NestOfGhosts/3d-chase/README.md

# 3d-chase
3d cube of led's as interface for simple game of snake without the body of the snake. Made by me for Hack Club Half Life.

Dear hack club reviewer. You may notice that most of the images are absolute garbage. Most are placeholders for when i do the project personally, and when I do ill add better images and remove this comment

## Premise

3d led cube:



But it's snake:



But the cube is 9x9x9 so i dont think the snake's body would work, so it's just going to be a led moving towards blinking leds.

### The game explaination
These are what the keys map to.



PWR just start the game, and does nothing beyond that. Why is it called PWR? Because I thought i was going to do more with the button. The other keys that move you along the x,y, and z axis.

You start in (0,0,0(Corner of the cube)) as the lit up led, and the goal starts in (1,1,1 (center of the cube)) as the blinking led. 
You have 3.5 seconds to move your light to the goal. A new goal will spawn, and every 3 points the time limit will go down. 

Here are the values for every time decrease (in milliseconds): 3500, 2940, 2505, 2168, 1907, 1703, 1546, 1424, 1329, 1255, 1198, 1154, 1119, 1093, 1072, 1056, 1043, 1034, 1026, 1020, 1016, 1012, 1009, 1007, 1006, 1005, 1004, 1003, 1002, 1001, 1000.

Past 90 points, the time stays at a static 1000 milliseconds (1 second). You effectively win if you can get to the points within 1 second without making a mistake. If you get to that level, you can try editing the firmware to have a different/steeper decrease slope.

If you move into a wall you fail.

### Additional Note
If you keep it plugged in it will go into a standby mode, where it'll randomly turn on the cubes leds until the cube is filled, then it'll clear it. Lets the cube work as simple decoration.

## Stuff you need

[BOM.csv](https://github.com/NestOfGhosts/3d-chase/blob/main/BOM.csv) is just a copy of the things I personally had to buy for the project and their prices, not a complete list of things you need. The following table is the complete parts list.

|Thing you need|What you need it for|
|---|---|
|Soldering equipment and expertise|A simple soldering iron and through-hole skills needed|
|[The Pcb](https://github.com/NestOfGhosts/3d-chase/tree/main/Pcb%20Files)|To hold everything together|
|[The Chassis](https://github.com/NestOfGhosts/3d-chase/tree/main/Chassis%20Files)|To hold everything together but in like a different way :3|
|Arduino Nano Atmega328 with usb c|Just kinda get some clone or something that seems legit enough and compatible/same pin layout as og nano. I got mine from [Aliexpress](https://www.aliexpress.com/item/1005006128051481.html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)|
|7 switches and keycaps|For the controls. Make sure they're mx compatible and 5 pin. MAKE SURE THEY'RE 5 PIN|
|27 Diode leds|The ones with only an anode and cathode, in any colour of your choosing. Im using flattop whites|
|3 Mosfets|Allows you to open and close electrical paths|
|9 ~130-330 ohm resistors|To limit electric flow going to leds. Higher number is more resistant = duller leds. Recommended ohm value is for white leds|
|3 4.7k-100k ohm resistors|Closes electrical path if mosfet isnt *fully* off|
|M4 screws and nuts|To hold the chassis together|
|Wires|I'm using some spare jumpers. Make sure you can connect points at ~20mm, ~40mm, ~60mm. (120mm of wires)|

### Additional notes: 
  - I got my pcb and chassis from JLCPCB and JLC3DP (respectively).
  - The pcb is fully designed for through hole parts
  - Flat topped, diffused leds work better for this projects, because realistically you're looking at the leds from multiple angles and you will be looking at them for periods of time (diffused spreads light out and reduces sharpness). However, diffused leds are expensive, so you can sand the led lightly with a high grit sandpaper (400-1000). Higher is less diffused.
  - Colour of leds correspond to resistor strengths. If you want a different led colour google "____ led resistor ohm"
  - The screws are ISO7380 M4. You may need to edit chassis screw holes if the screws you buy are bigger
  - The firmware is built for the old Atmega328 bootloader. If you want to change it you need to copy the firmware folder, open it in [VS Code](https://code.visualstudio.com), and download [Platformio](https://platformio.org/) (you can also find this in vscode's built in extension store). Then, in the platformio.ini folder change from REMEMBER TO CHANGE THIS
  - The resistor value is are for white leds. You can use [All About Circuits Led Resistor Calculators](https://www.allaboutcircuits.com/tools/led-resistor-calculator/) to calculate it. Aim for about roughly 10-20ma~? It really depends on every Led though so the value is a broad number. You can look at the listing for max ma, and maybe do a couple underneath that.

## Assembly
### Firmware
Instructions are windows
1. Download firmware .hex from [the firmware folder](https://github.com/NestOfGhosts/3d-chase/blob/main/FIrmware/firmware.hex) 
2. Download a .hex firmware flasher [Avrdude](https://blog.zakkemble.net/avrdudess-a-gui-for-avrdude/)
3. Open device manager, and expand the "Ports (COM & LPT)"
4. Plug in the nano. A new port should appear. Take note of the COM number (etcetcetc (COM___))
5. In Avrdude, set preset to "Arduino Nano (Atmega328p)". You may have purchased a Nano with a Atmega328 or Atmega328PB MCU. If so, change MCU to the correct one.


6. In Avrdude, set port to the COM number. Other programmer setting should be correct because of the preset.


7. Add the path to the .hex in the "Flash" field. Set it to "Write", and press "Go"
8. Wait until the terminal at the bottom of the gui says "Success" or smth

### Soldering
Hopefully you have a fume extractor, or have accepted asthma and metals in your lungs
1. Solder the Nano, MOSFETS, and resistors on the backside.
2. Solder switches on frontside.
#### The led cube
3. (Optional): Sand your leds if you more diffusion
4. Bend the cathodes(shorter side) of the leds 90 degrees, with a 1-3mm gap between the bottom of the led and the start of the bend
5. Lay out the leds in a 3x3 grid. Match it up with the hole distances in the pcb (all 2 leds are seperated by 15mm). Make a second bend on the horizontal plane to make each distance between leds 15mm.


(PLACEHOLDER IMAGE)

6. Connect the anodes(longer side) up and down. Make the distance between the layers 15mm to make C U B E.


(PLACEHOLDER IMAGE)

7. Get the wires. Make sure both ends are stripped/open/metal. Now solder one end of the wire on one of the three holes to the left of the pcb (pins labeled L1, L2, L3). IMPORTANT: Wire the bottom most layer to L1, top layer to L3 etc


8. Grab the chassis cover, and route the wires through the holes in the cover.
INSERT IMAGE
9. Solder the wires to the 3x3 layers, and solder the anode columns to the pcb
10. Put the chassis together

## Customizing the firmware.
You need to know c++ to do major changes, because platformio uses c++, but I will go through some simple changes if you dont know C++
- Install [Platformio](https://platformio.org/) on [VS Code](https://code.visualstudio.com)
- Download the [3d Chase Folder](https://github.com/NestOfGhosts/3d-chase/tree/main/FIrmware/3d%20Chase%20Firmware) by pasting the url into [Download Github directory](https://download-directory.github.io/)
- Extract the download
- To open the platformio project, follow the first *commenter*'s instructions in [this forum post](https://community.platformio.org/t/guidance-for-a-platform-io-noob/47188) on how to open platformio projects.
- Now, in src, you can find the main.cpp folder. Top of the file has some simple settings like debounce(how long a button has to be held to be considered pressed), how long the goal's blinks are, and how long one frame of the standby's animation is. On line 86, you can also find the time limit curve. If you dont know c++, i recommend maintaining the timeTable at 31 values, but you can adjust the indivisual values, like making the curve go down faster and end at 500, if you want a challenge. If you want a smoother curve than just guessing values you can use a graphing calculator and your favourite function to create your own curve. 

## Arduino Pins, for the nerds:
D0 = Power button
D1, D2, D3, D4, D5, D6 = X+, X-, Y+, Y-, Z+, Z-
D7, D8, D9 = MOS1, MOS2, MOS3
D10, D11, D12, D13, D14, D15, D16, D17, D18 = Column 1, 2, 3, 4, 5, 6, 7, 8, 9
