NestOfGhosts/3d-chase/BOM.csv

Item | Qty | Supplier | Cost/item | Total Cost | link
Mosfet | 3 | Digikey | $1.72 | $5.16 | https://www.digikey.ca/en/products/detail/microchip-technology/TN0702N3-G/4902376
Leds | 100 | Aliexpress | $0.06 | $6.00 | https://www.aliexpress.com/item/1005007478725108.html?mp=1
Resistors (150 ohm) | 12 | Digikey | $0.04 | $0.48 | https://www.digikey.ca/en/products/detail/yageo/MFR-25FBF52-150R/12831
Resistors (7.68 KOhms) | 3 | Digikey | $0.11 | $0.33 | https://www.digikey.ca/en/products/detail/yageo/MFR-25FBF52-7K68/13197
Arduino Nano w/ type C | 1 | Aliexpress | $4.74 | $4.74 | https://www.aliexpress.com/item/1005011773197580.html?mp=1
Screws and nuts (M4) | 5 | Aliexpress | $0.66 | $3.30 | https://www.aliexpress.com/item/1005005971756266.html?mp=1
Pcb | 1 | JLCPCB | $8.80 | $8.80 | https://jlcpcb.com
Chassis | 1 | JLC3DP | $4.32 | $4.32 | https://jlc3dp.com
Estimated total shipping | 1 |  |  | $33.26
