NestOfGhosts/3d-chase/Chassis Files/cassis-Assembly.step

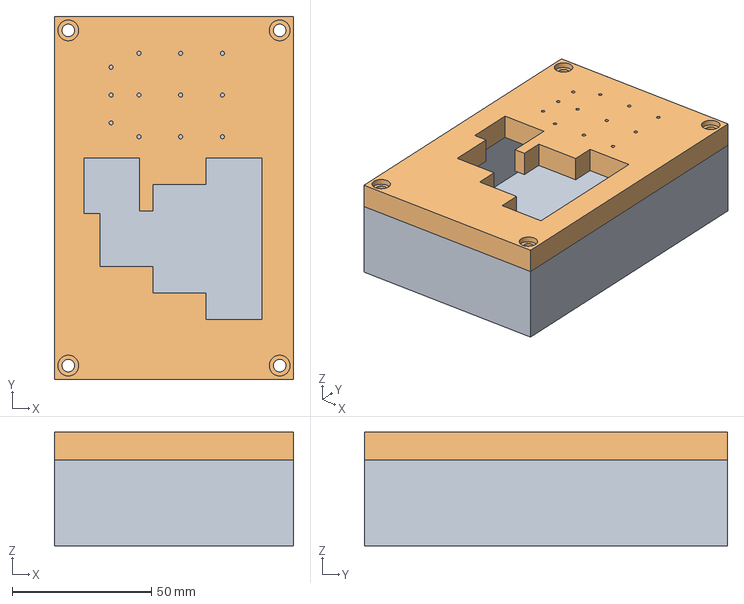
[picture p1: CAD file, 2026-11-01]
Chassis Files/cassis-Assembly.step
86.0 x 130.5 x 40.8 mm
