NestOfGhosts/3d-chase/Chassis Files/Split files/002-Body001(1)-1(1).stl

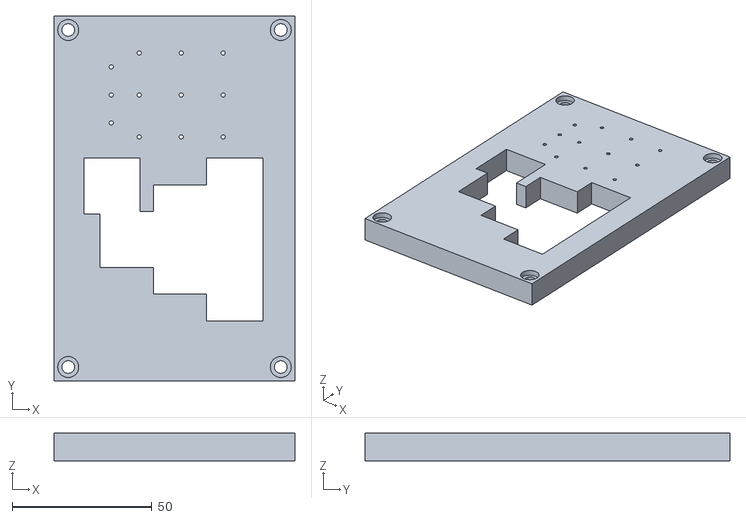
[picture p2: CAD file, 2026-11-01]
Chassis Files/Split files/002-Body001(1)-1(1).stl
86.0 x 130.5 x 10.00
