NestOfGhosts/3d-chase/Chassis Files/cassis.step

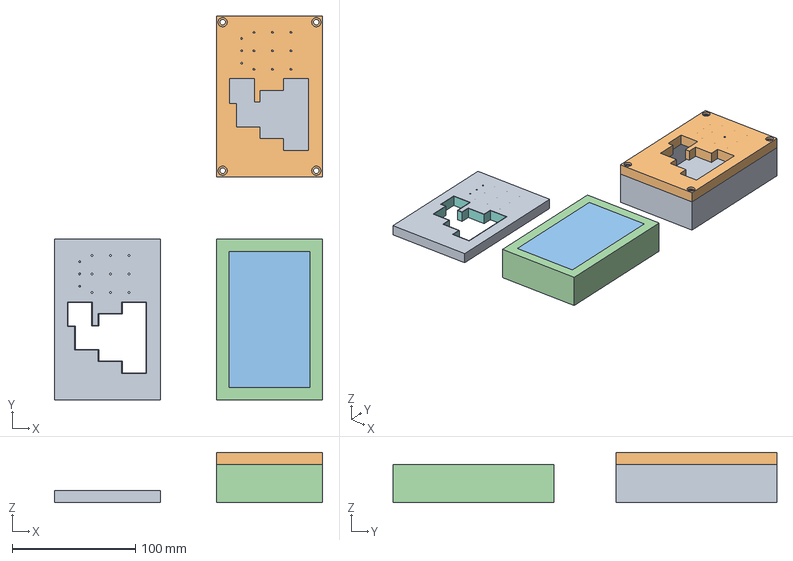
[picture p3: CAD file, 2026-11-01]
Chassis Files/cassis.step
217.4 x 311.5 x 40.8 mm
Hole
Hole001
Sketch005
Sketch006
