NestOfGhosts/3d-chase/Chassis Files/Split files/001-Body(1)-1(1).stl

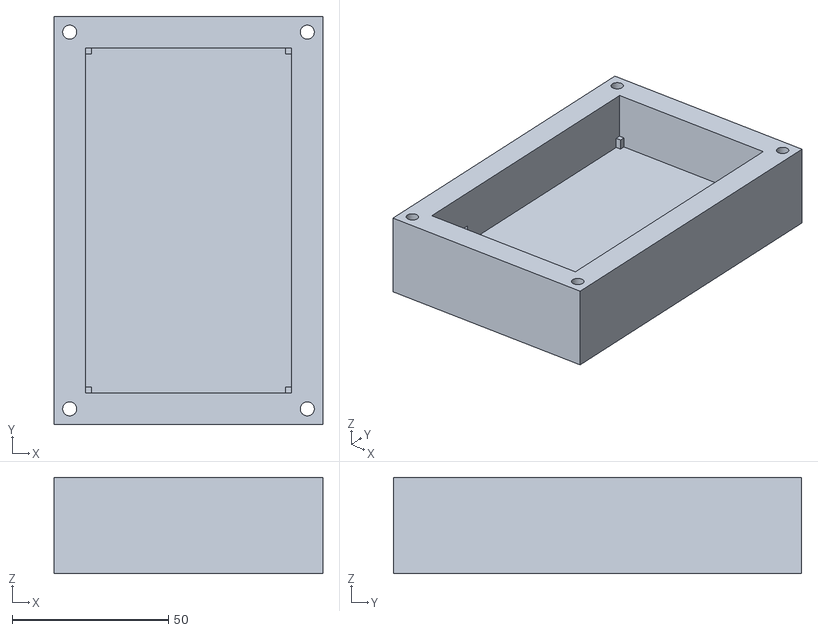
[picture p4: CAD file, 2026-11-01]
Chassis Files/Split files/001-Body(1)-1(1).stl
86.0 x 130.5 x 30.8
