NestOfGhosts/3d-chase/(list of files, cad)

Other CAD files:
Chassis Files/Split files/001-Body(1)-1.step
Chassis Files/Split files/002-Body001(1)-1.step
Chassis Files/cassis-Assembly.stl
Chassis Files/cassis.FCStd
Chassis Files/cassis.stl
