NestOfGhosts/3d-chase/Pcb Files/chase.kicad_pcb

## KiCad design Pcb Files/chase.kicad_pcb (2026-10-30)

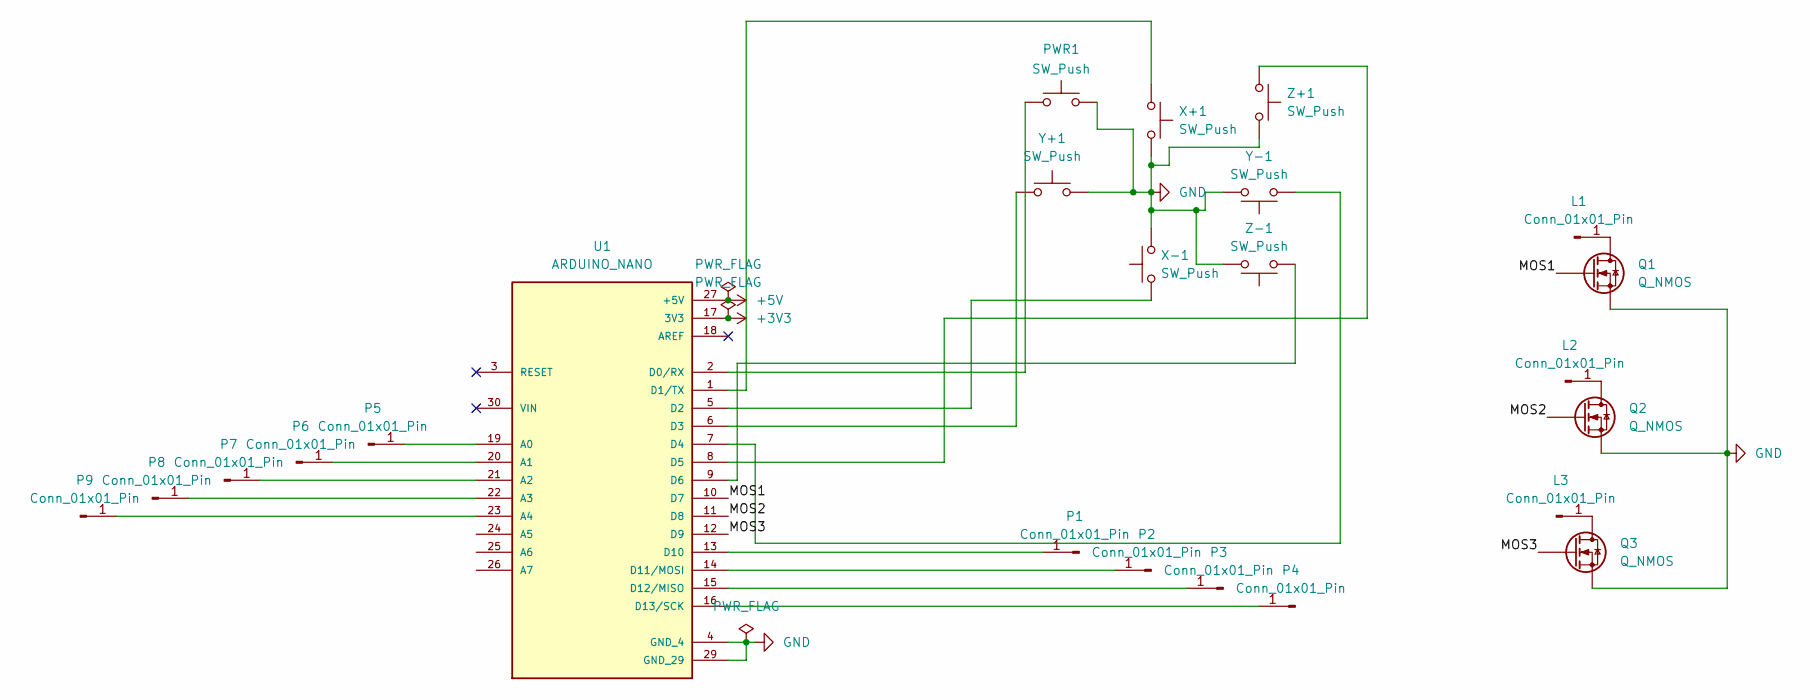
[picture p5: schematic chase.kicad_sch]

Parts:
L1, L2, L3: Conn_01x01_Pin; SolderWire-0.5sqmm_1x01_D0.9mm_OD2.1mm
P1, P2, P3, P4, P5, P6, P7, P8, P9: Conn_01x01_Pin; SolderWire-0.5sqmm_1x01_D0.9mm_OD2.1mm
PWR1: SW_Push; SW_Cherry_MX_1.00u_PCB
Q1, Q2, Q3: Q_NMOS; 1x3 1mm diameter through holes
U1: ARDUINO_NANO; Arduino_Nano; PARTREV 30/06/2021
X+1: SW_Push; SW_Cherry_MX_1.00u_PCB
X-1: SW_Push; SW_Cherry_MX_1.00u_PCB
Y+1: SW_Push; SW_Cherry_MX_1.00u_PCB
Y-1: SW_Push; SW_Cherry_MX_1.00u_PCB
Z+1: SW_Push; SW_Cherry_MX_1.00u_PCB
Z-1: SW_Push; SW_Cherry_MX_1.00u_PCB

Connections:
+3V3: U1.17 (3V3)
+5V: U1.27 (+5V)
/MOS1: Q1.G, U1.10 (D7)
/MOS2: Q2.G, U1.11 (D8)
/MOS3: Q3.G, U1.12 (D9)
GND: PWR1.2, Q1.S, Q2.S, Q3.S, U1.4 (GND_4), U1.29 (GND_29), X+1.2, X-1.2, Y+1.2, Y-1.2, Z+1.2, Z-1.2
unnamed: L1.1 (Pin_1_1), Q1.D
unnamed: L2.1 (Pin_1_1), Q2.D
unnamed: L3.1 (Pin_1_1), Q3.D
unnamed: P1.1 (Pin_1_1), U1.13 (D10)
unnamed: P2.1 (Pin_1_1), U1.14 (D11/MOSI)
unnamed: P3.1 (Pin_1_1), U1.15 (D12/MISO)
unnamed: P4.1 (Pin_1_1), U1.16 (D13/SCK)
unnamed: P5.1 (Pin_1_1), U1.19 (A0)
unnamed: P6.1 (Pin_1_1), U1.20 (A1)
unnamed: P7.1 (Pin_1_1), U1.21 (A2)
unnamed: P8.1 (Pin_1_1), U1.22 (A3)
unnamed: P9.1 (Pin_1_1), U1.23 (A4)
unnamed: PWR1.1, U1.2 (D0/RX)
unnamed: U1.1 (D1/TX), X+1.1
unnamed: U1.5 (D2), X-1.1
unnamed: U1.6 (D3), Y+1.1
unnamed: U1.7 (D4), Y-1.1
unnamed: U1.8 (D5), Z+1.1
unnamed: U1.9 (D6), Z-1.1

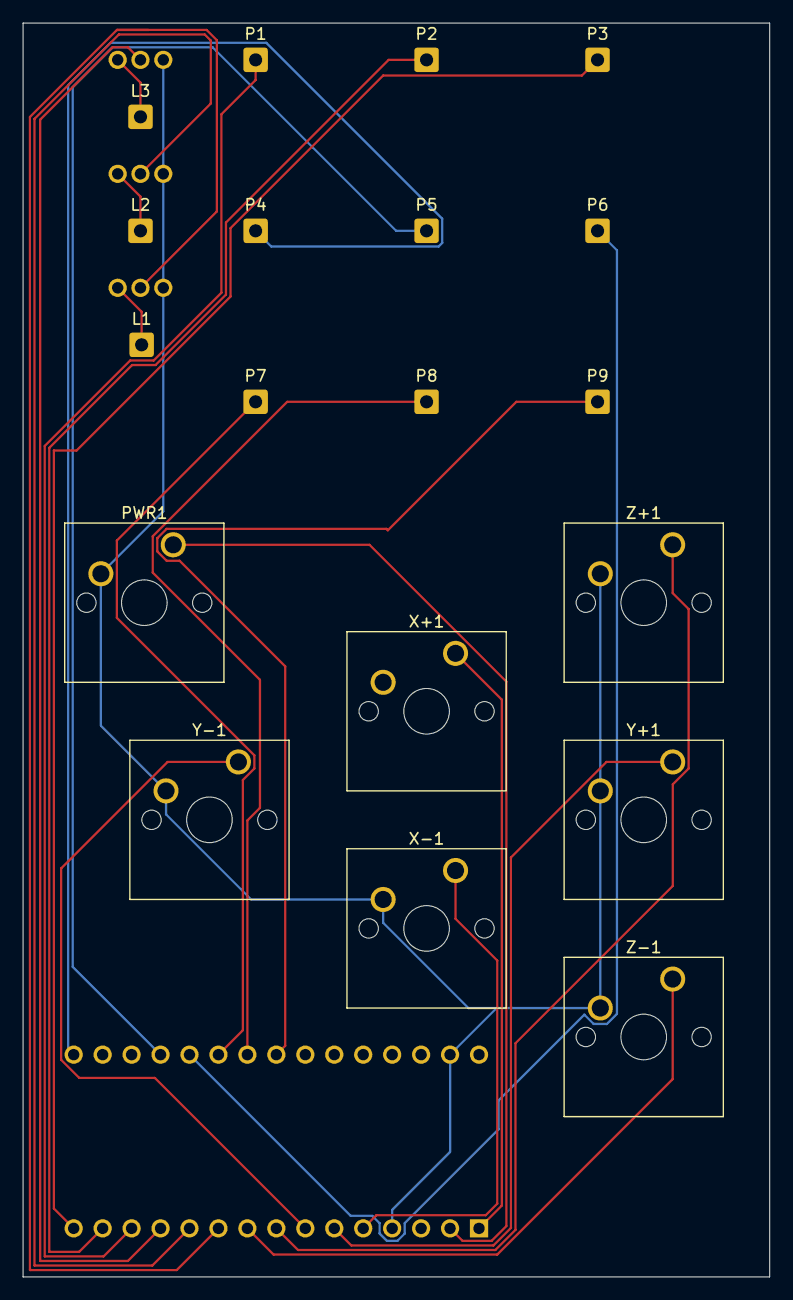
[picture p6: board chase.kicad_pcb from above]

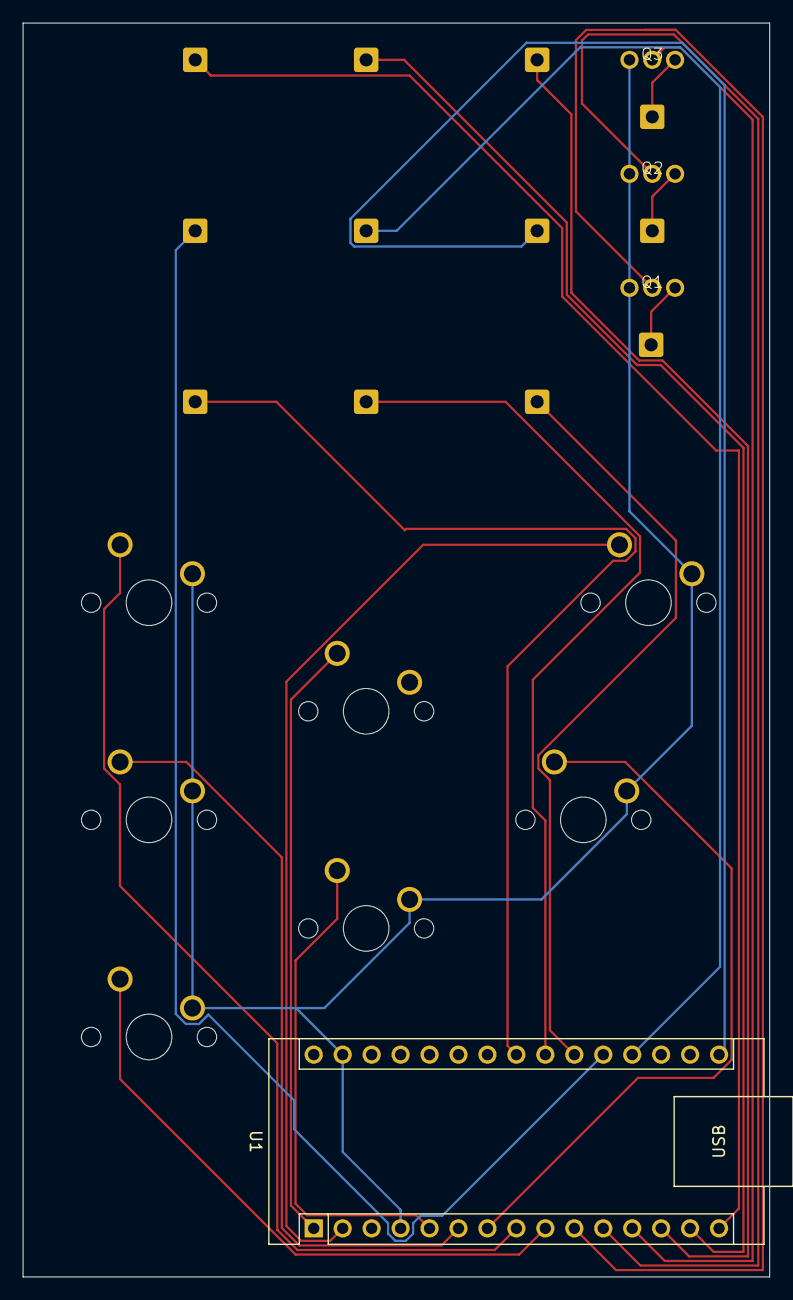
[picture p7: board chase.kicad_pcb from below]

Board: 2 copper layers, 65.5 x 110.0 mm, 23 parts (4 on the bottom side), 23 nets.
