NestOfGhosts/3d-chase/JOURNAL.md

# 3d Chase: devlog

<!-- Generated by Half Life from project be5bj1qxvsdfmrgahmt9hvr9. Edits here are overwritten on the next sync. -->
<!-- Generated: 2026-11-02T00:07:23.185Z -->

> [!NOTE]
> This devlog is mirrored from [Half Life](https://halflife.hackclub.com) ([open the project](https://halflife.hackclub.com/projects/be5bj1qxvsdfmrgahmt9hvr9)). Editing it here will not change the platform's copy, and the next sync overwrites this file.

> 3 by 3 led cube as a display, and you are a led in the cube, and your goal is to go to the blinking led. Once you do another one spawns and the time frame to get the goal goes down. You die if you move into a wall

| Week | Tier | Hours logged | Entries |
| --- | --- | --- | --- |
| Week 4 | Tier 2 | 16.25h | 10 |

## Contents

1. [2026-10-27: Started pcb design for the thing. The mosfet's schematic was expecting a pad S G D, and instead of just finding a footprint with that my goofy ahh made my own. There I also realized that with standard](#2026-10-27-started-pcb-design-for-the-thing-the-mosfets-sche)
2. [2026-10-28: finished pcb, started chassis](#2026-10-28-finished-pcb-started-chassis)
3. [2026-10-29: Continued finishing chassis](#2026-10-29-continued-finishing-chassis)
4. [2026-10-29: Finish chassis, start shopping, start readme, start contemplating screw choices, changes screws, Note to self for next time: Remember to change screw holes on the chassis for the new screws](#2026-10-29-finish-chassis-start-shopping-start-readme-start-)
5. [2026-10-31: Had to rewire it several time because:](#2026-10-31-had-to-rewire-it-several-time-because)
6. [2026-10-31: # CODINGSS](#2026-10-31-codingss)
7. [2026-10-31: Updating readme](#2026-10-31-updating-readme)
8. [2026-11-01: Updated readme, Added holes to chassis. Found some cheap leds](#2026-11-01-updated-readme-added-holes-to-chassis-found-some-)
9. [2026-11-01: I did some coding on my pc (i dont have vscode on windows bc i dont know how to get git up and running). Atp i finished display and game logic. Now im working on adding animations for standby and lose](#2026-11-01-i-did-some-coding-on-my-pc-i-dont-have-vscode-on-)
10. [2026-11-01: Finished readme and the project :)](#2026-11-01-finished-readme-and-the-project)

## Design

### 2026-10-27: Started pcb design for the thing. The mosfet's schematic was expecting a pad S G D, and instead of just finding a footprint with that my goofy ahh made my own. There I also realized that with standard

**3.07h**

Started pcb design for the thing. The mosfet's schematic was expecting a pad S G D, and instead of just finding a footprint with that my goofy ahh made my own. There I also realized that with standard padstack thicknesses I need to bend the pins on the mosfets, which i kinda just accepted. So uh. OK

[Timelapse](https://lookout.hackclub.com/api/media/5a35c3e3-d16a-4060-ac18-8780d7ea8def/video.mp4)

### 2026-10-28: finished pcb, started chassis

**2.22h**

finished pcb, started chassis

[Timelapse](https://lookout.hackclub.com/api/media/599ad0e1-eef9-4b42-bf59-d127cbe3d64f/video.mp4)

### 2026-10-29: Continued finishing chassis

**0.67h**

Continued finishing chassis

[Timelapse](https://lookout.hackclub.com/api/media/75c57e02-0c41-47d4-8950-88a38385c4a5/video.mp4)

### 2026-10-29: Finish chassis, start shopping, start readme, start contemplating screw choices, changes screws, Note to self for next time: Remember to change screw holes on the chassis for the new screws

**1.42h**

Finish chassis, start shopping, start readme, start contemplating screw choices, changes screws, Note to self for next time: Remember to change screw holes on the chassis for the new screws

[Timelapse](https://lookout.hackclub.com/api/media/f71f8b0e-46aa-420c-bae9-380607046fa2/video.mp4)

### 2026-10-31: Had to rewire it several time because:

**3.63h**

Had to rewire it several time because:
- Im an idiot and i couldnt even understand the instructables or claudes explaination of the led matrix
- I forgot that leds need resistors D:

I finalized bom and continued readme

[Timelapse](https://lookout.hackclub.com/api/media/e787e6ca-8c3d-4704-a537-b105ba68d2c2/video.mp4)

### 2026-10-31: # CODINGSS

**0.8h**

# CODINGSS
## Majority time tracked by hackatime.

First issue:

Confused why tf there were two copies of the folder. Turns out they were two copies of the same folder in the workspace

First learning:


Learn what enum is

Second learning:


Learned what structs are.

### 2026-10-31: Updating readme

**0.52h**

Updating readme

[Timelapse](https://lookout.hackclub.com/api/media/6b1dc182-af8e-40f6-8132-d514a6953759/video.mp4)

### 2026-11-01: Updated readme, Added holes to chassis. Found some cheap leds

**1.77h**

Updated readme, Added holes to chassis. Found some cheap leds

[Timelapse](https://lookout.hackclub.com/api/media/26a0fe97-6efe-42a7-aaab-b0394334e45a/video.mp4)

### 2026-11-01: I did some coding on my pc (i dont have vscode on windows bc i dont know how to get git up and running). Atp i finished display and game logic. Now im working on adding animations for standby and lose

**1.37h**

I did some coding on my pc (i dont have vscode on windows bc i dont know how to get git up and running). Atp i finished display and game logic. Now im working on adding animations for standby and lose screens

[Timelapse](https://lookout.hackclub.com/api/media/6853e232-f769-4bac-894a-91b5ef2a2c2e/video.mp4)

### 2026-11-01: Finished readme and the project :)

**0.78h**

Finished readme and the project :)

[Timelapse](https://lookout.hackclub.com/api/media/22585b33-b5f3-436a-b324-f2c074c7973d/video.mp4)
