NestOfGhosts/3d-chase/(commit log)

2026-10-30 Whole chassis uploads
    [cassis.FCStd, cassis.step, cassis.stl]
2026-10-30 Sync 3d Chase from Half Life
    [BOM.csv]
